magicmicros/ml7280_clone/images/connectors/HAL_connector.jpg

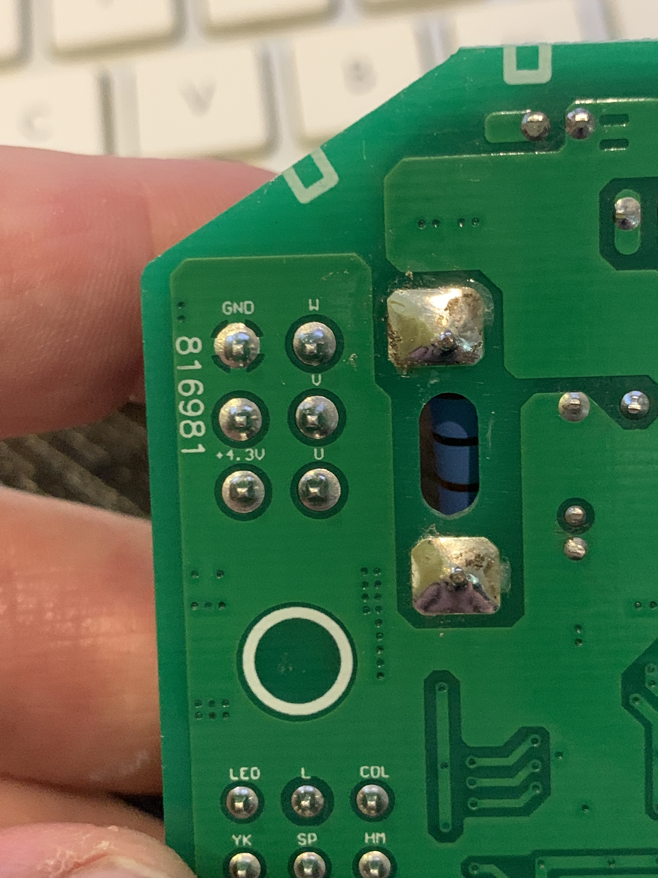
images/connectors/HAL_connector.jpg
