magicmicros/ml7280_clone/images/connectors/Main_connector.jpg

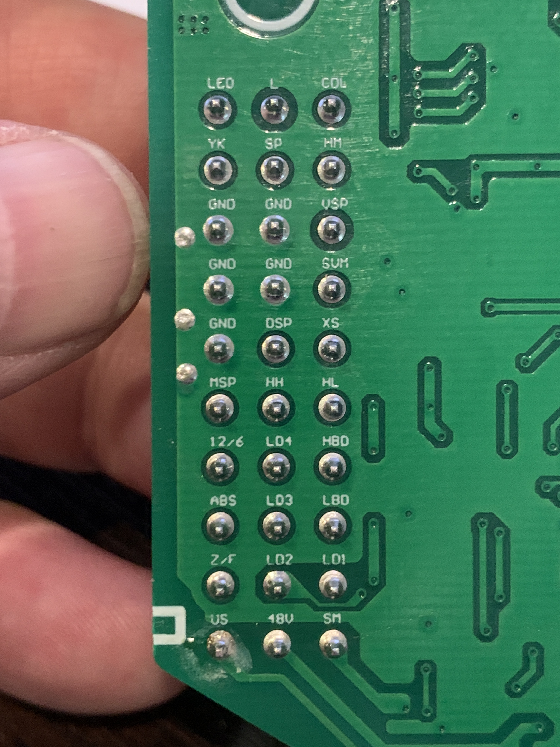
images/connectors/Main_connector.jpg
