magicmicros/ml7280_clone/images/connectors/Programming_connector.jpg

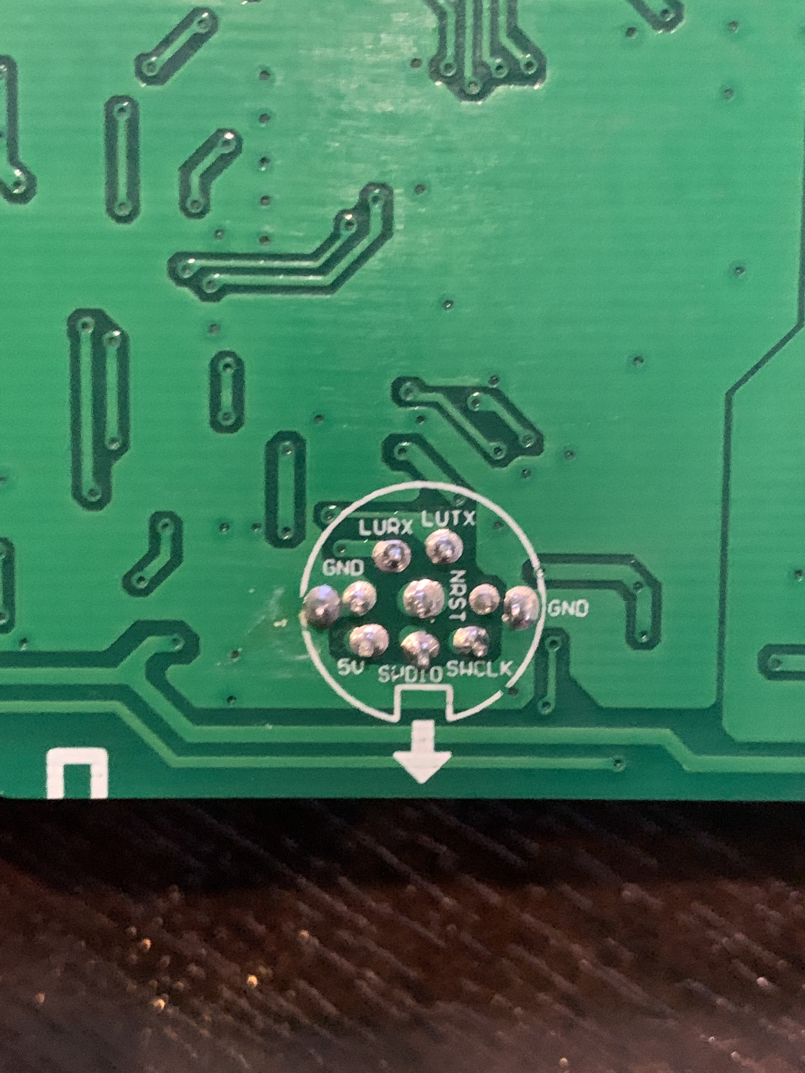
images/connectors/Programming_connector.jpg
