magicmicros/ml7280_clone/images/enclosure/IMG_3983.JPG

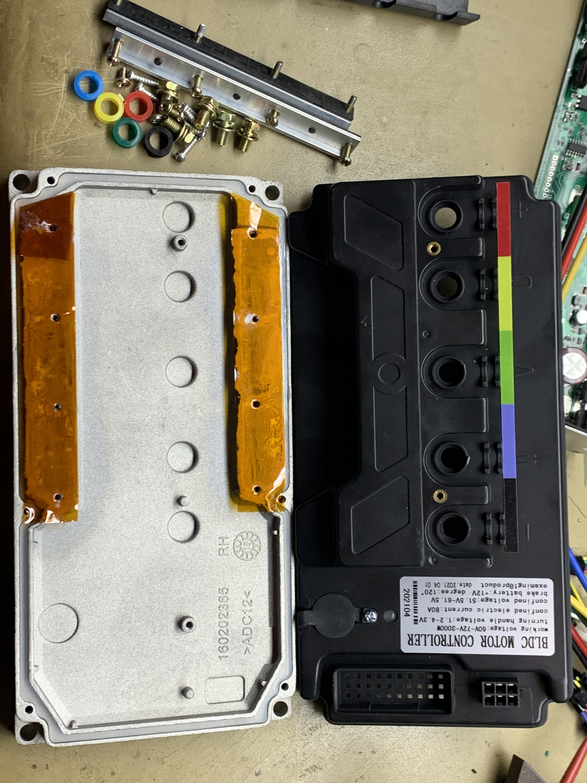
images/enclosure/IMG_3983.JPG
