magicmicros/ml7280_clone/images/enclosure/IMG_3984.JPG

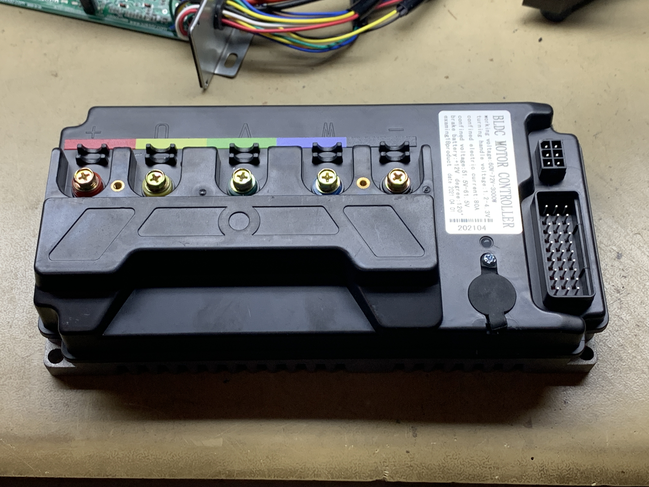
images/enclosure/IMG_3984.JPG
