magicmicros/ml7280_clone/images/pcb/IMG_3965.JPG

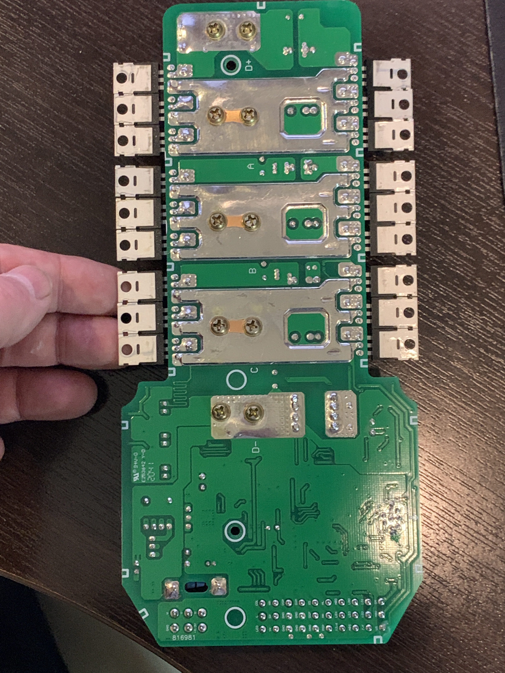
images/pcb/IMG_3965.JPG
