magicmicros/ml7280_clone/images/track_details/High_Side_Driver.JPG

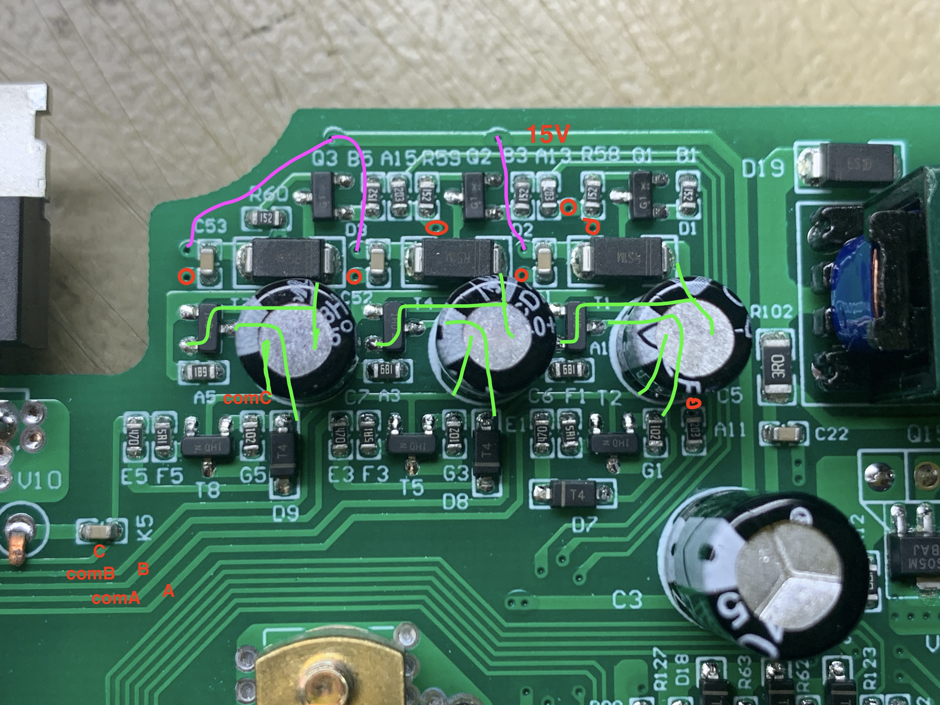
images/track_details/High_Side_Driver.JPG
