magicmicros/ml7280_clone/images/track_details/IMG_3979.JPG

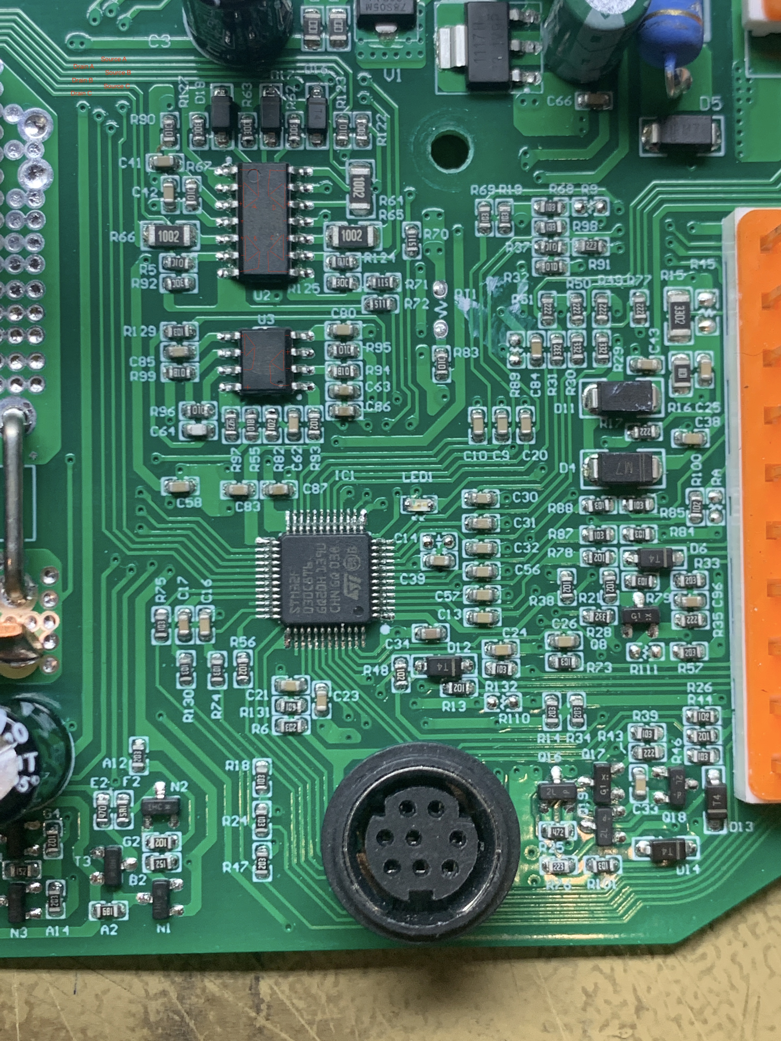
images/track_details/IMG_3979.JPG
