magicmicros/ml7280_clone/images/track_details/IMG_3981.JPG

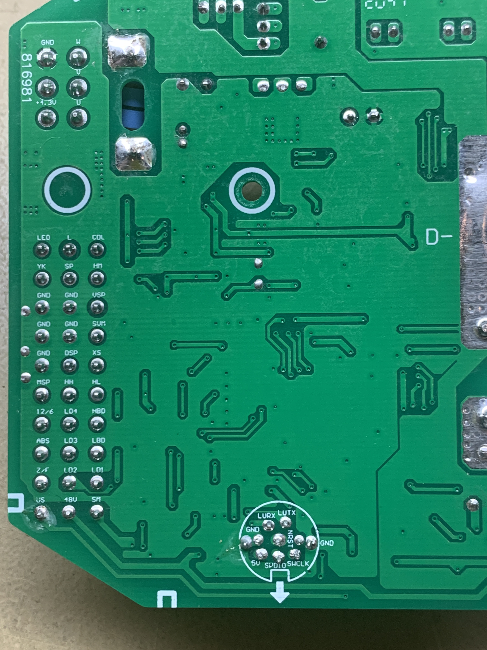
images/track_details/IMG_3981.JPG
