magicmicros/ml7280_clone/images/track_details/Low_Side_Driver.JPG

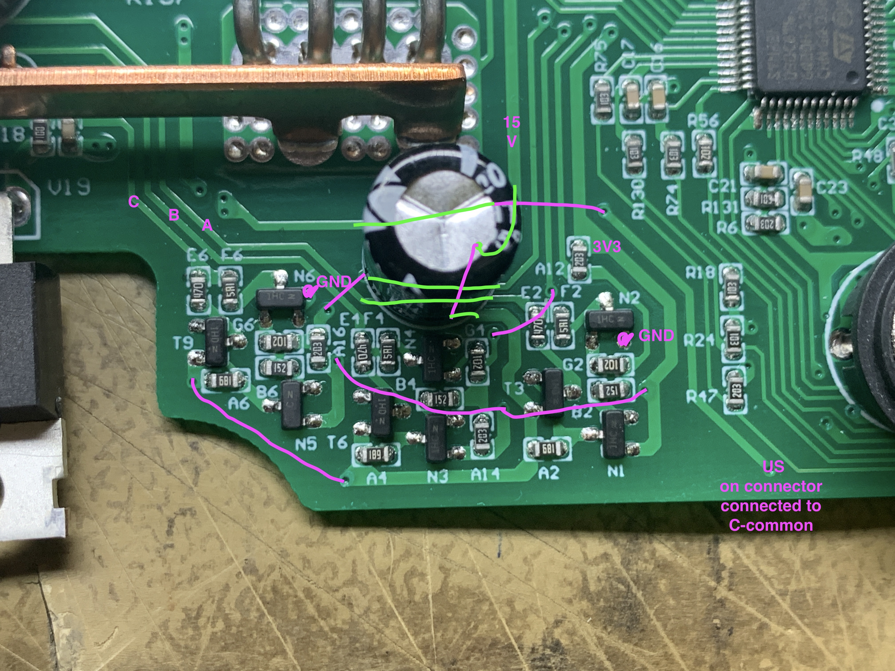
images/track_details/Low_Side_Driver.JPG
