magicmicros/ml7280_clone/images/track_details/Power_Supply.JPG

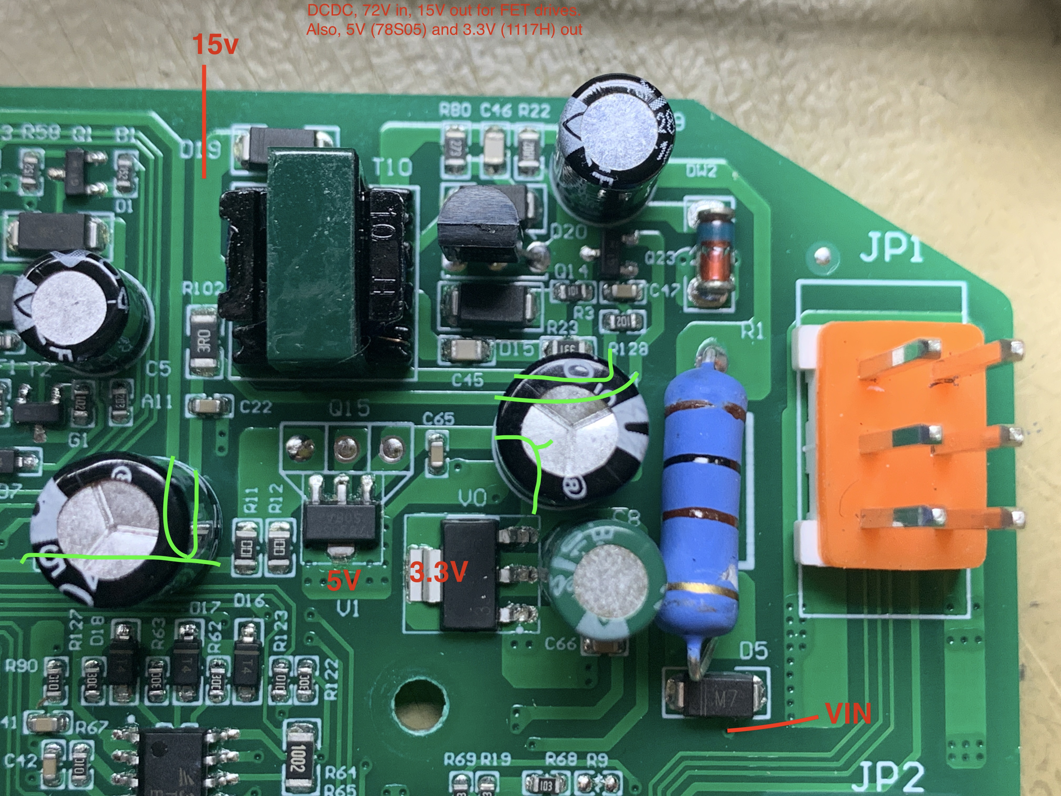
images/track_details/Power_Supply.JPG
