magicmicros/ml7280_clone/simulation/output_stage.png

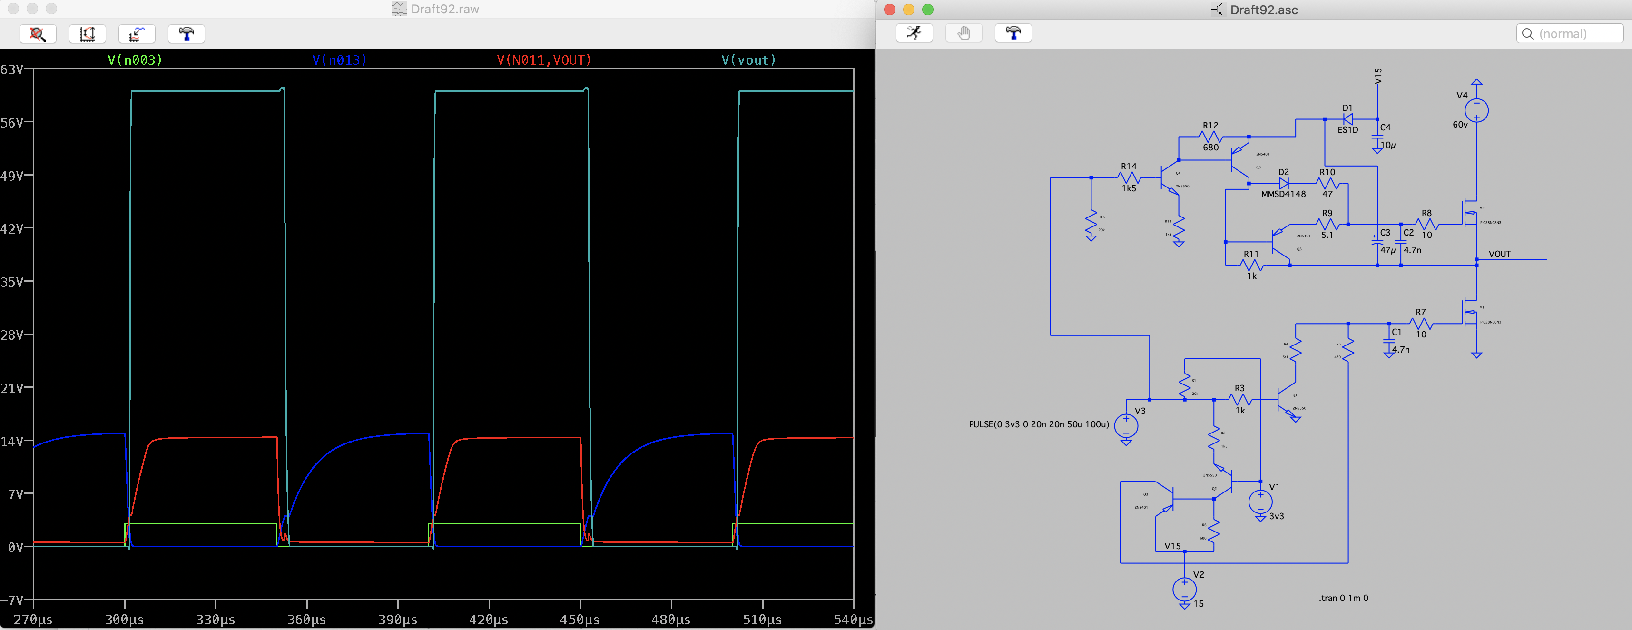
simulation/output_stage.png
