magicmicros/ml7280_clone/simulation/power_supply.png

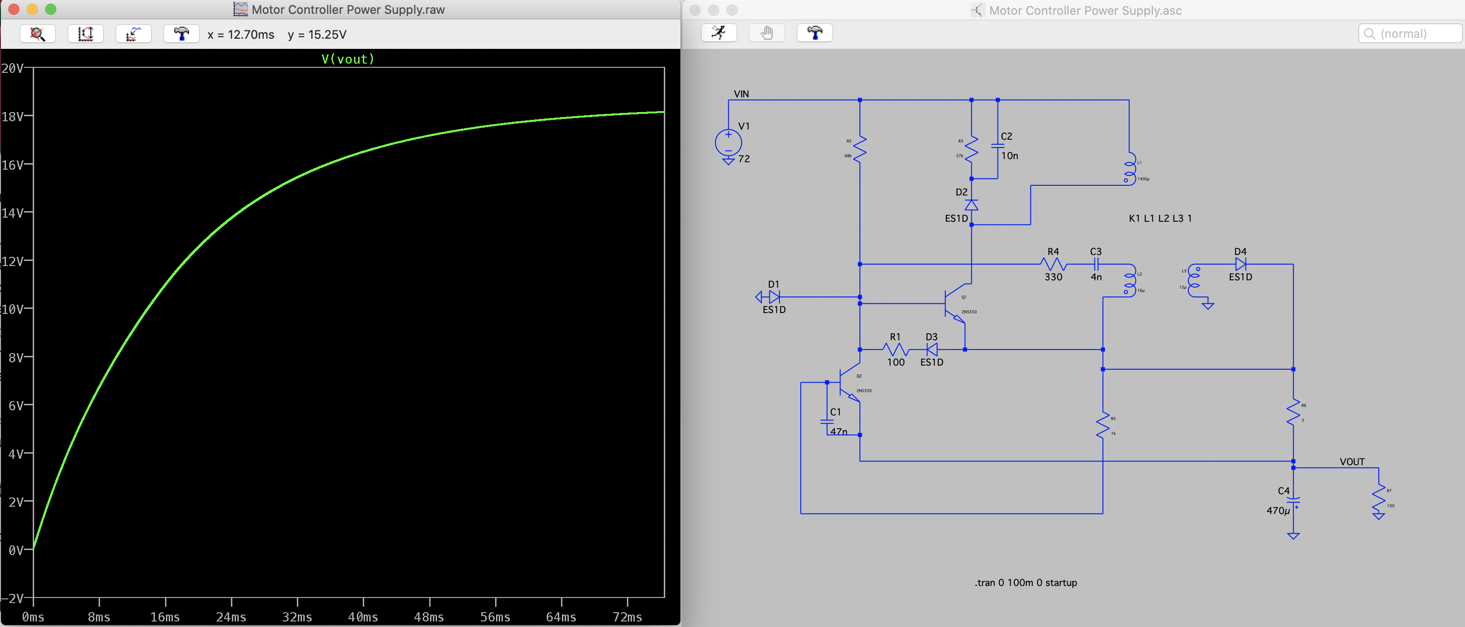
simulation/power_supply.png
