magicmicros/ml7280_clone/schematics/ML7280_clone_schematic.pdf

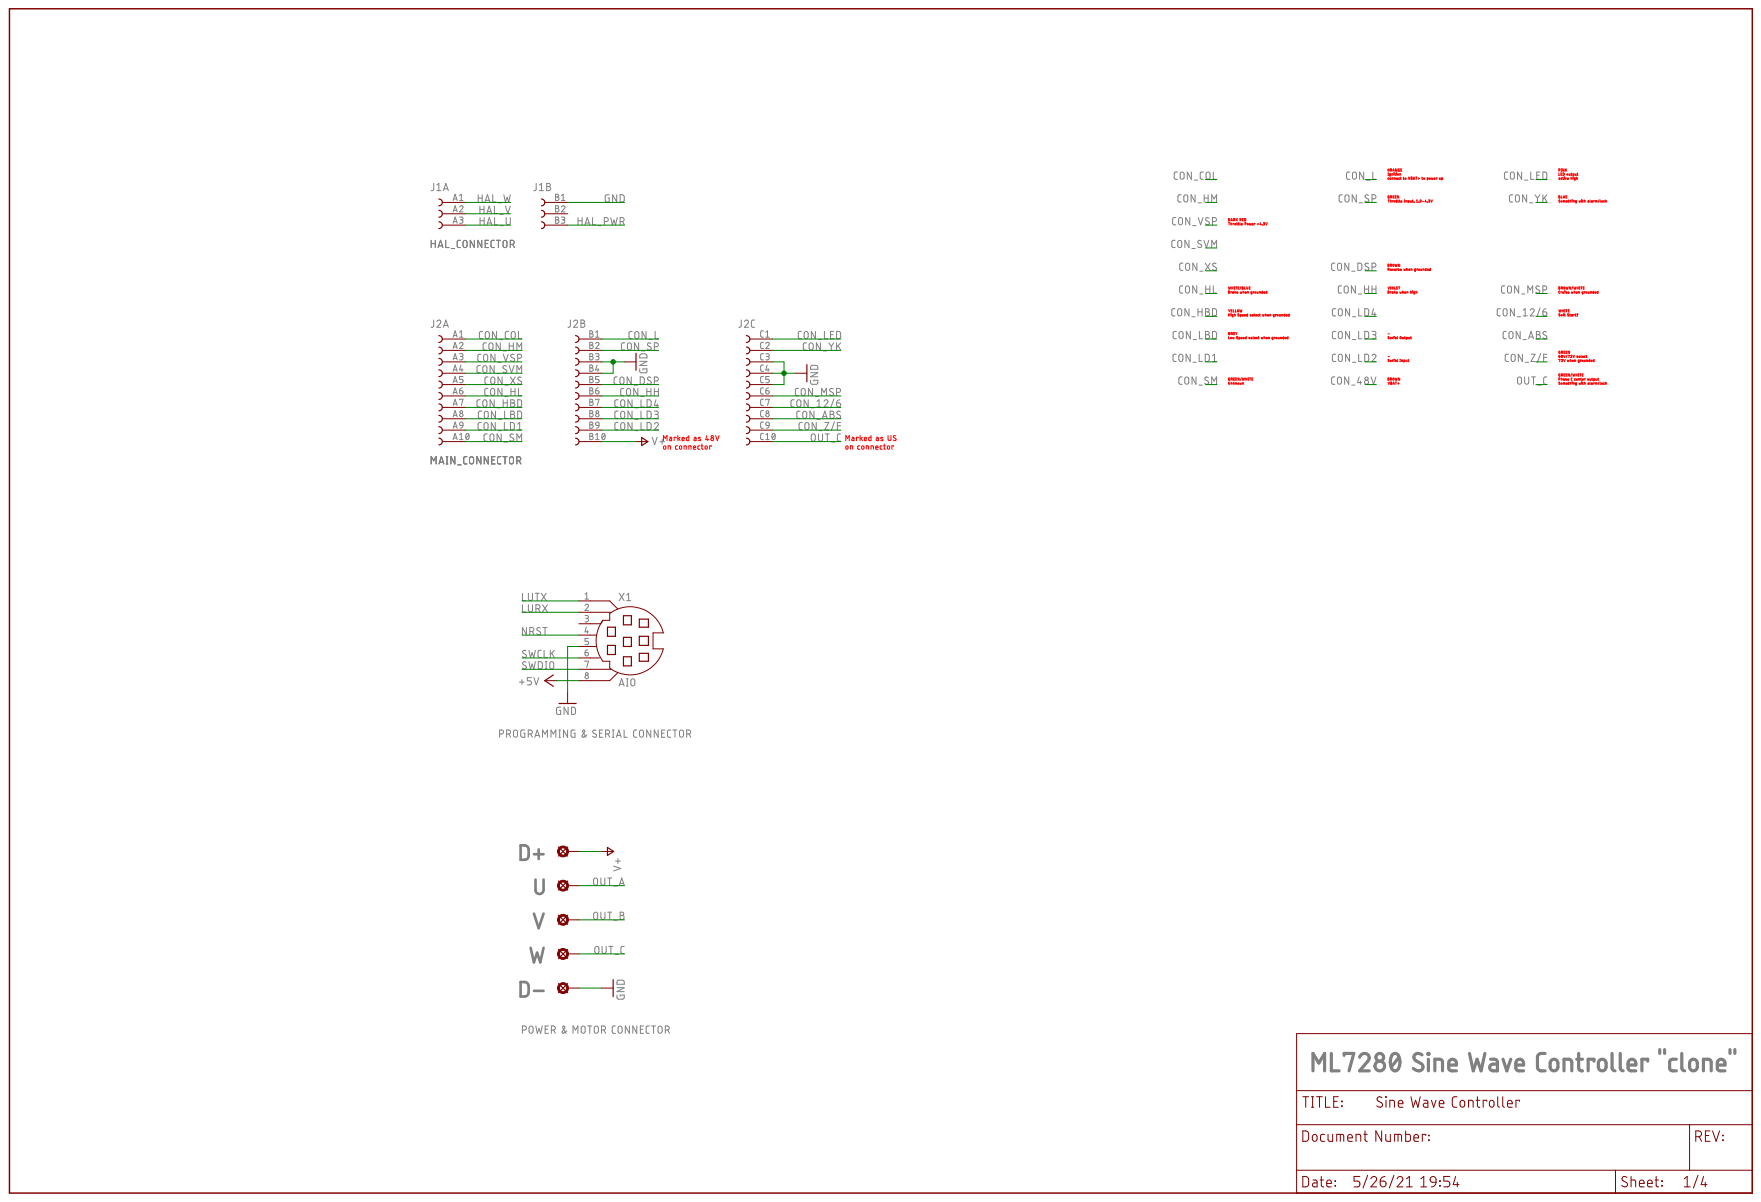
[picture p21: page 1]

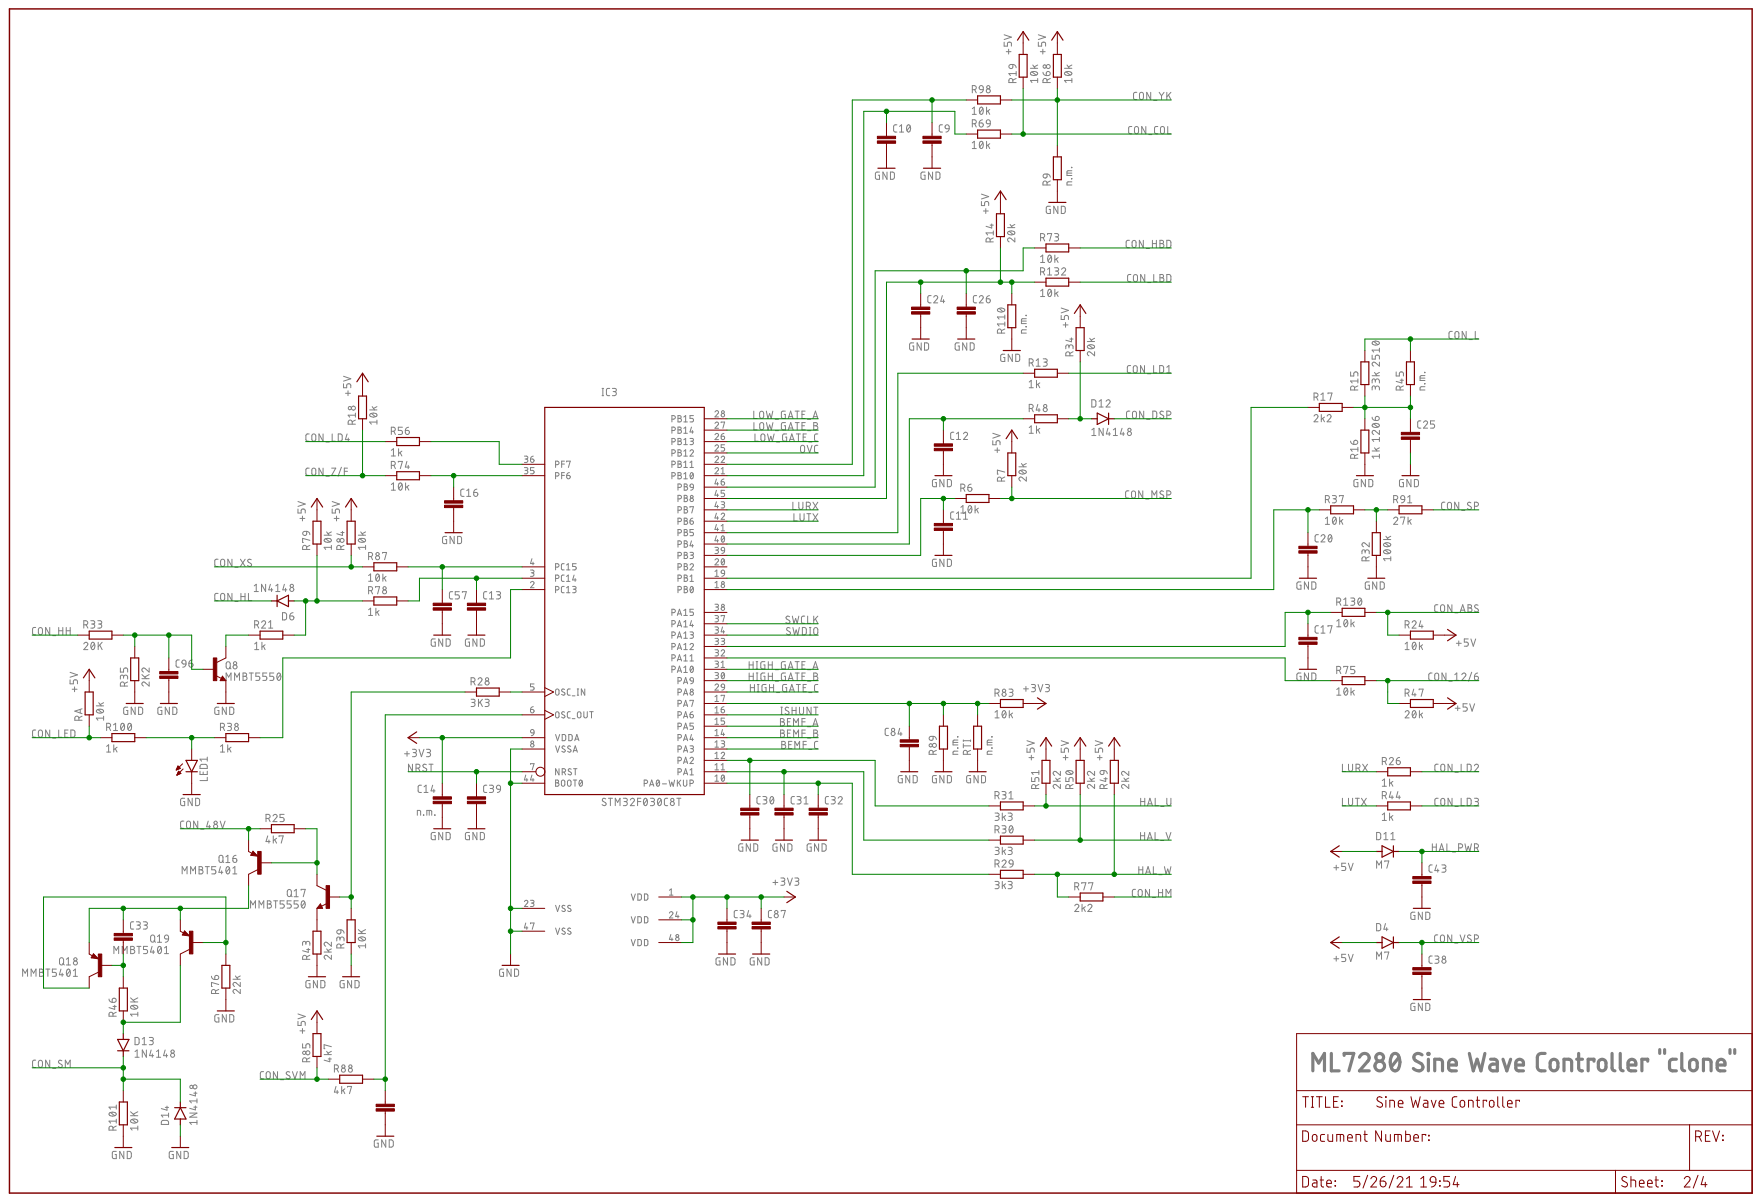
[picture p22: page 2]

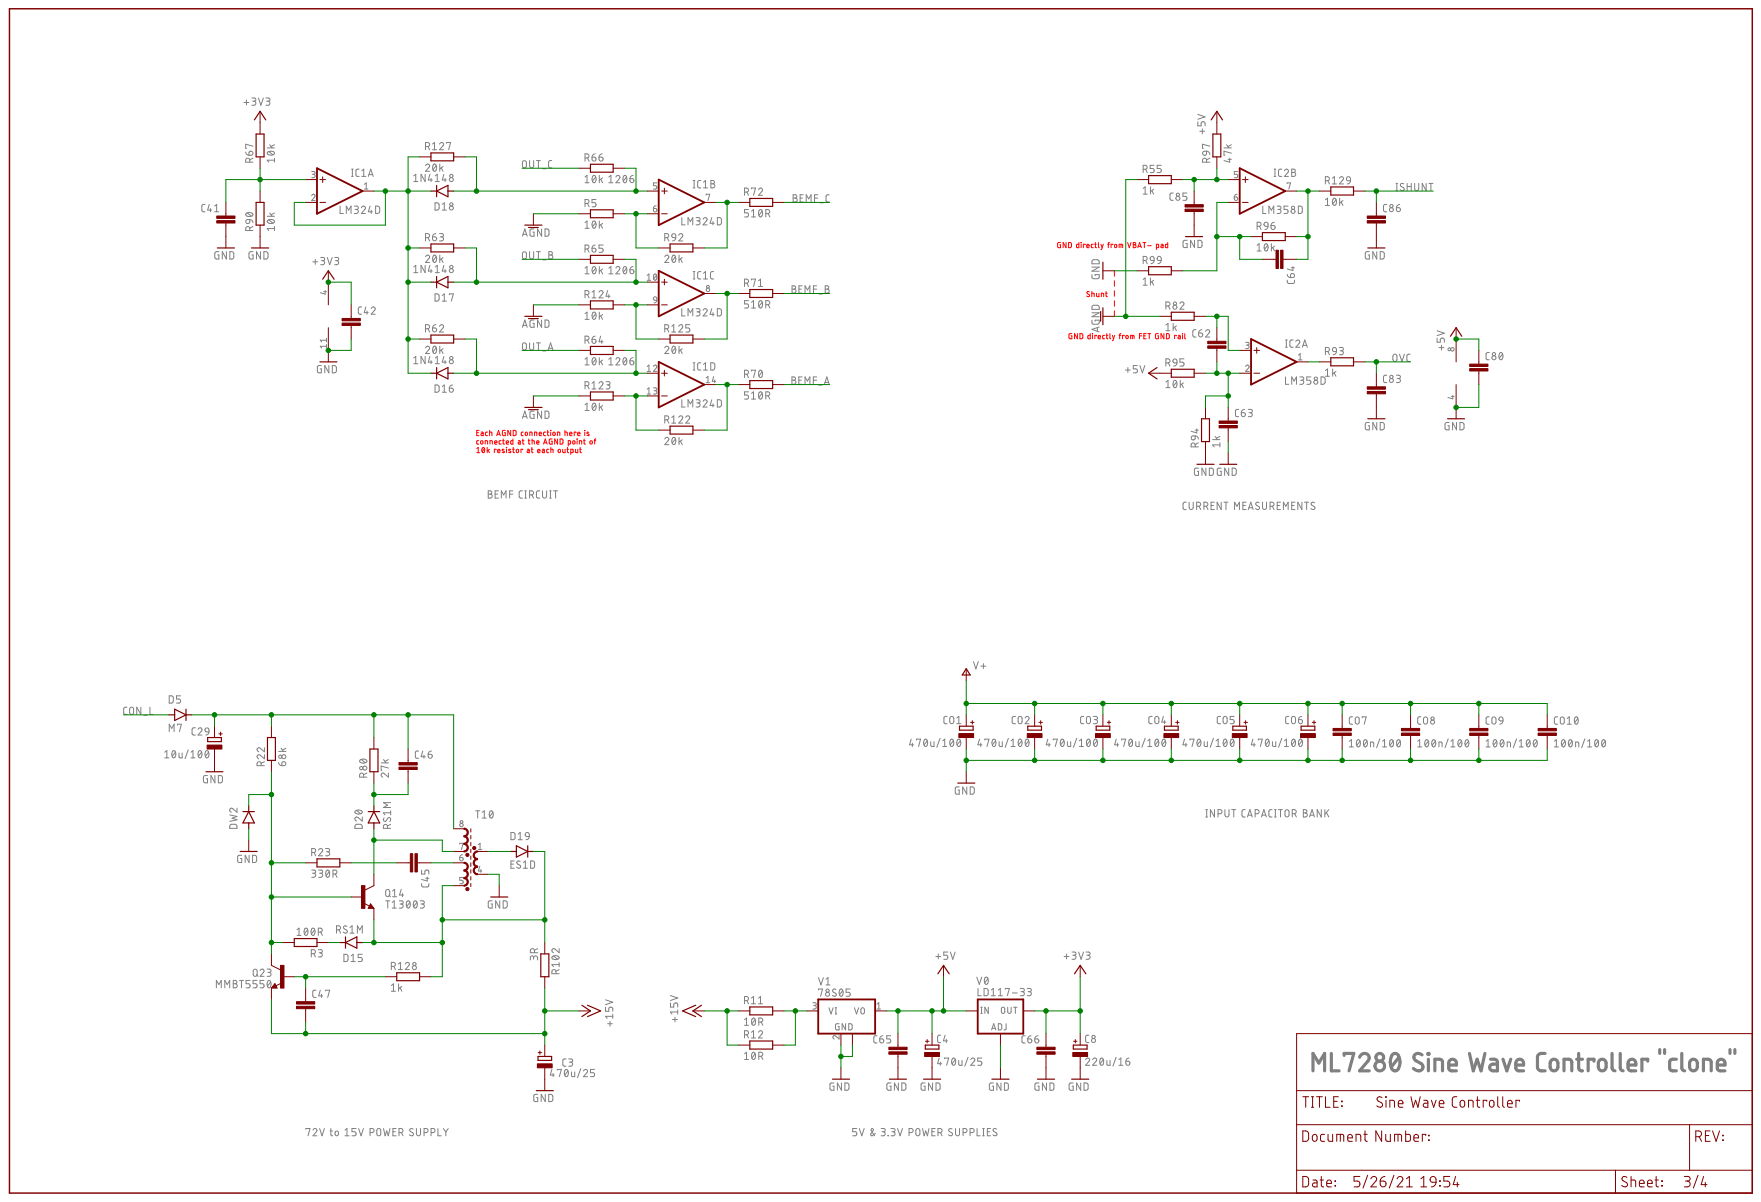
[picture p23: page 3]

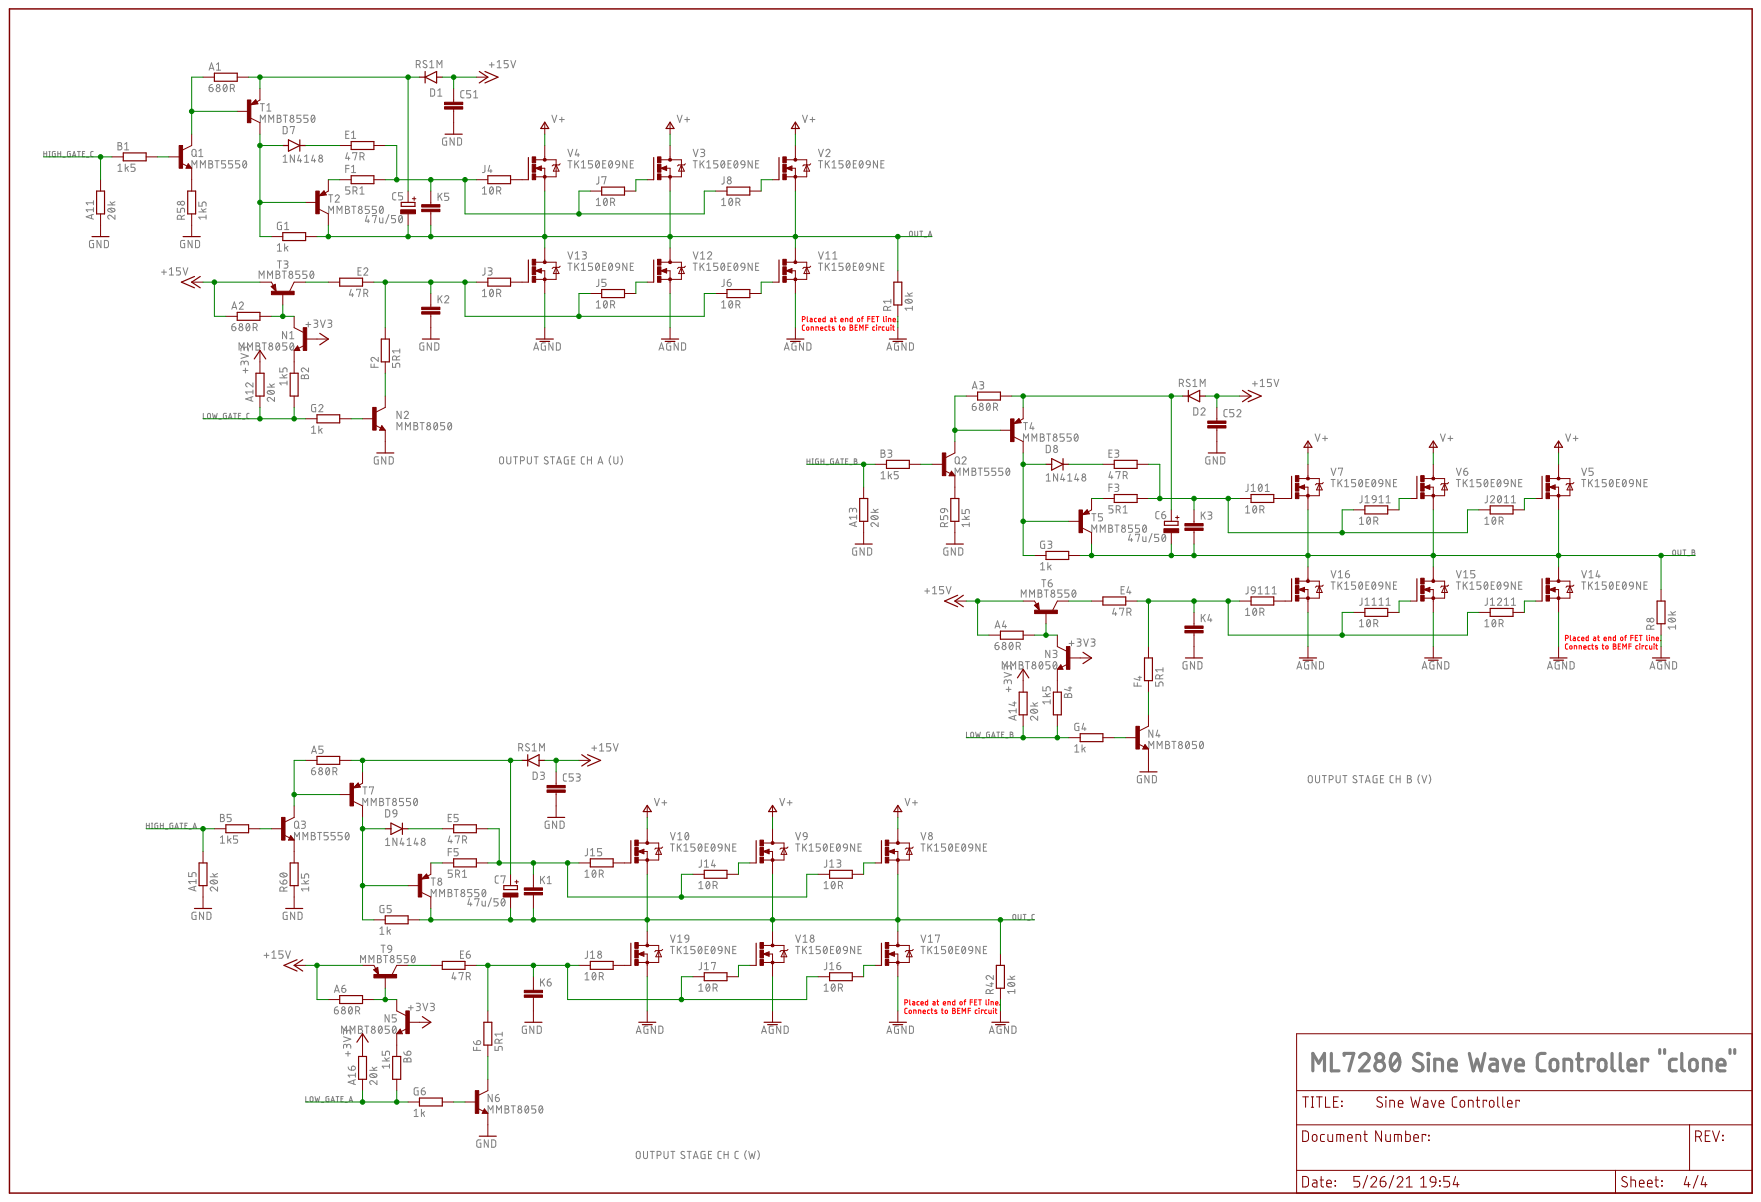
[picture p24: page 4]
