magicmicros/ml7280_clone/simulation/Motor Controller Gate Driver Linear.asc

C1: cap; 4.7n
C2: cap; 4.7n
C3: polcap; 47µ; Rser=650m Lser=0 mfg="Nichicon" pn="UPR1J470MPH" type="Al electrolytic"
C4: cap; 10µ
D1: diode; ES1D
D2: diode; MMSD4148
M1: nmos; IPI028N08N3
M2: nmos; IPI028N08N3
Q1: npn; 2N5550
Q2: npn; 2N5550
Q3: pnp; 2N5401
Q4: npn; 2N5550
Q5: pnp; 2N5401
Q6: pnp; 2N5401
R1: res; 20k
R2: res; 1k5
R3: res; 1k
R4: res; 5r1
R5: res; 470
R6: res; 680
R7: res; 10
R8: res; 10
R9: res; 5.1
R10: res; 47
R11: res; 1k
R12: res; 680
R13: res; 1k5
R14: res; 1k5
R15: res; 20k
V1: voltage; 3v3
V2: voltage; 15
V3: voltage; PULSE(0 3v3 0 20n 20n 50u 100u)
V4: voltage; 60v
Named nets: 0, VOUT, V15
.tran 0 1m 0
