magicmicros/ml7280_clone/simulation/Motor Controller Power Supply.asc

C1: cap; 47n
C2: cap; 10n
C3: cap; 4n
C4: polcap; 470µ; Rser=76m Lser=0 mfg="Nichicon" pn="UPR2A471MRH" type="Al electrolytic"
D1: diode; ES1D
D2: diode; ES1D
D3: diode; ES1D
D4: diode; ES1D
L1: ind2; 1400µ
L2: ind2; 16µ
L3: ind2; 15µ
Q1: npn; 2N5550
Q2: npn; 2N5550
R1: res; 100
R2: res; 68k
R3: res; 27k
R4: res; 330
R5: res; 1k
R6: res; 3
R7: res; 100
V1: voltage; 72
Named nets: 0, VIN, VOUT
K1 L1 L2 L3 1
.tran 0 100m 0 startup
