magicmicros/ml7280_clone/images/pcb/IMG_3962.JPG

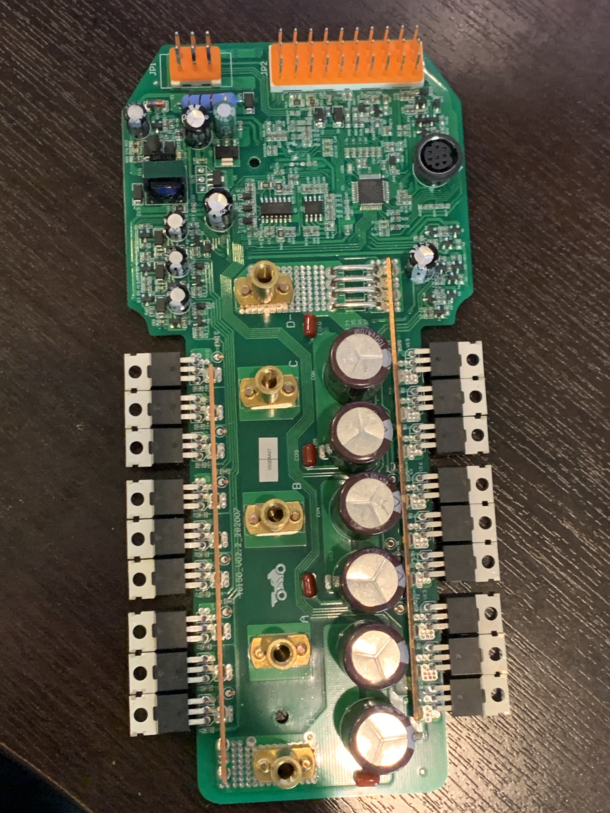
images/pcb/IMG_3962.JPG
