magicmicros/ml7280_clone/images/pcb/IMG_3963.JPG

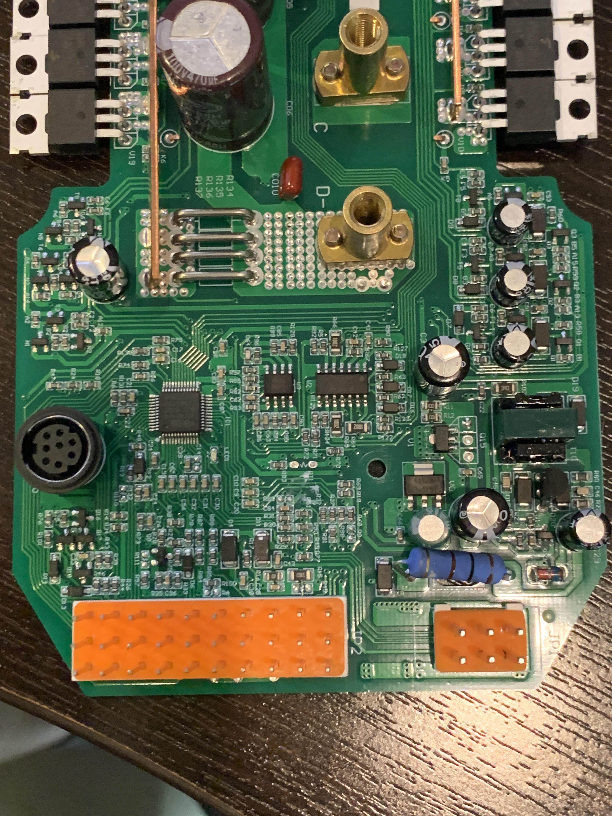
images/pcb/IMG_3963.JPG
