magicmicros/ml7280_clone/images/track_details/IMG_3978.JPG

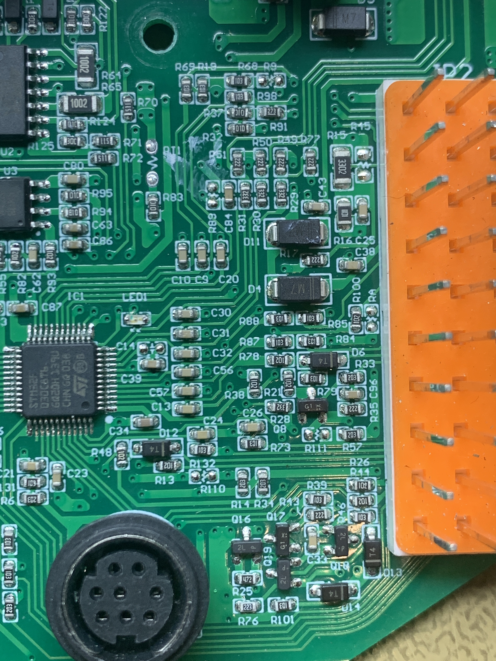
images/track_details/IMG_3978.JPG
