magicmicros/ml7280_clone/images/track_details/IMG_3980.JPG

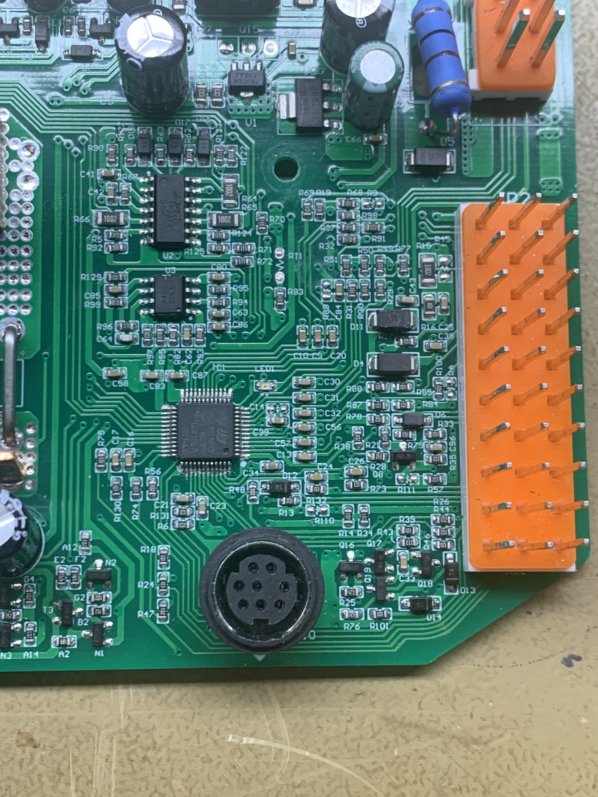
images/track_details/IMG_3980.JPG
